robotont/robotont-electronics-power-management-board/README.md

# robotont-electronics-power-management-board
The repository contains schematics and PCB layout for the Robotont power management board.
The [production](Production/) folder contains prepared gerbers with pos file ready to order a from e.g. JLCPCB.

## Schematics
Schematic

## Layout

The following figures visualize the front side of the board along with the 3D model of the design.

PCB Layout
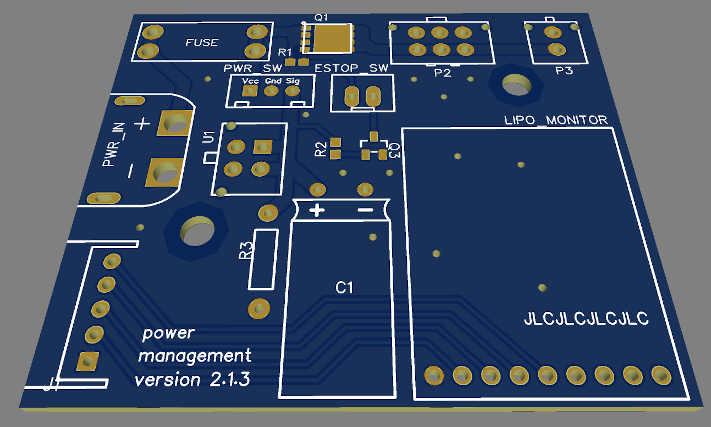
[picture p1: docs/robotont-power-management-board-3d.png]
3D View
