robotont/robotont-electronics-power-management-board/Production/robotont_power_management_board_schematic.pdf

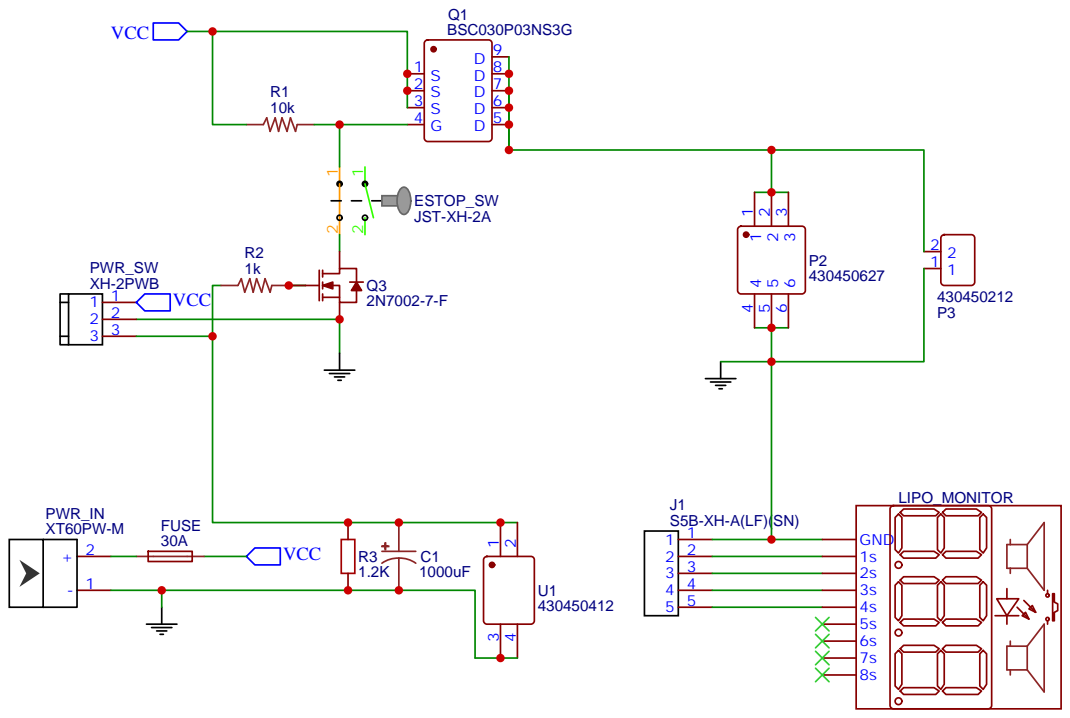
[picture p2: page 1]

Company: University of Tartu

Drawn By: Veiko Vunder
