robotont/robotont-electronics-power-management-board/(list of files, drawings)

Other design files:
EasyEDA_PCB_power_management.json
EasyEDA_SCH_power_management.json
