robotont/robotont-electronics-power-management-board/robotont-power-management-board.kicad_pcb

## KiCad design robotont-power-management-board.kicad_pcb (2021-10-05)

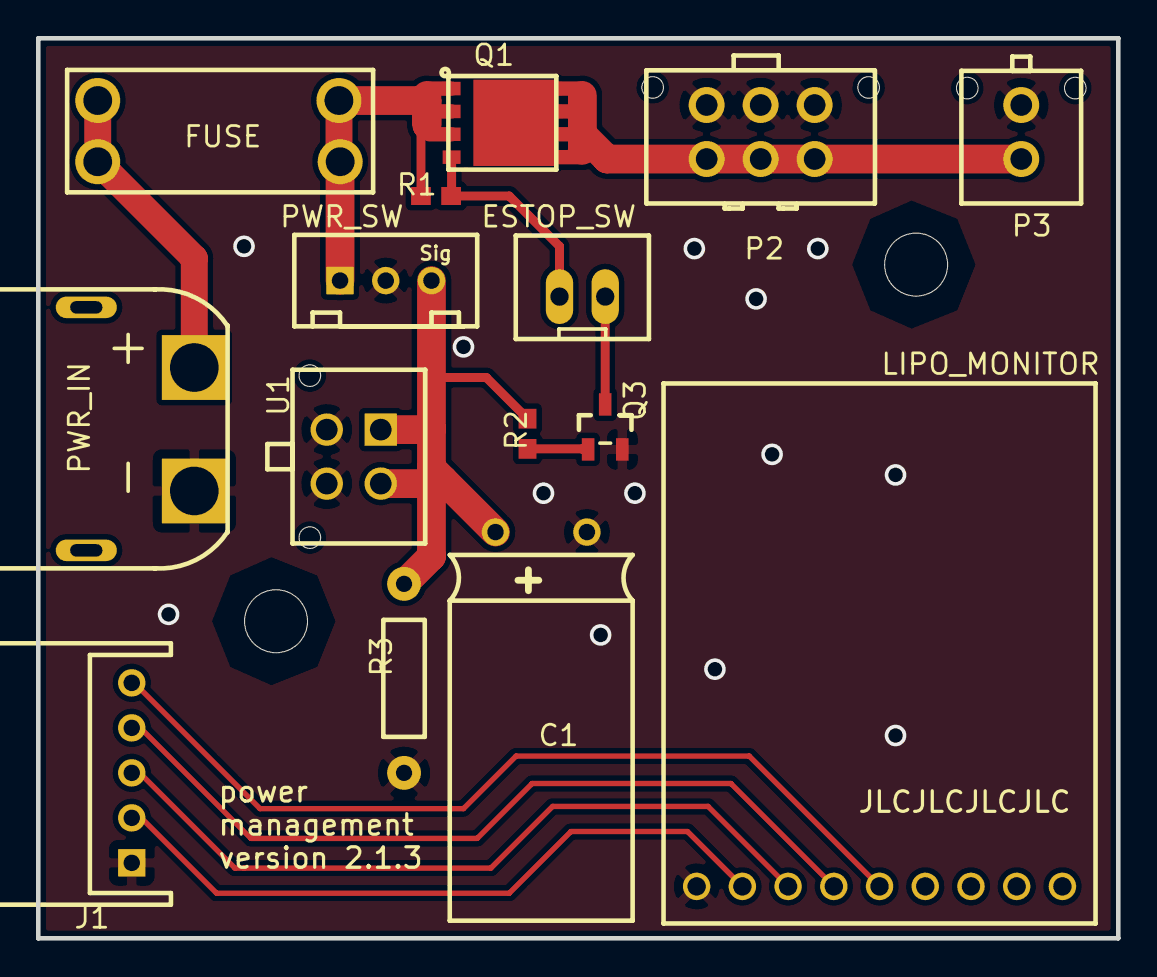
[picture p3: board robotont-power-management-board.kicad_pcb from above]

Board: 2 copper layers, 60.0 x 50.0 mm, 15 parts (0 on the bottom side), 12 nets.

Parts:
C1: +; ELECTROLYTIC CAP HORIZONTAL 10X20MM
ESTOP_SW: 1; JST-XH-02-PACKAGE-LONG-PAD
FUSE: 30A; 3557-2
J1: S5B-XH-A(LF)(SN); JST-XH-S5B-XH-A
LIPO_MONITOR: LiPo Tester; LIPO_BATTERY_TESTER
P2: 430450627
P3: 430450212
PWR_IN: XT60PW-M; XT60PW-M PCBLIB
PWR_SW: Sig; JST-XH-3PIN TD
Q1: BSC030P03NS3G; SON-8_5MMX6MM
Q3: 2N7002-7-F; SOT-23-3_L2.9-W1.6-P1.90-LS2.8-BR
R1: 10k; 0603-RES
R2: 1k; 0603-RES
R3: 1.2K; RES-TH_BD2.3-L6.5-P10.50-D0.5
U1: 430450412; CONN-TH_4P-P3.00-S3.00_L7.4-W9.7-EH9.0

Connections:
C1_2: C1.2, PWR_SW.3, R2.1, R3.2, U1.1, U1.2
ESTOP_SW_1: ESTOP_SW.1, Q1.4, R1.2
ESTOP_SW_2: ESTOP_SW.2, Q3.3
FUSE_1: FUSE.1, PWR_IN.2
GND: C1.1, J1.1, LIPO_MONITOR.1, P2.4, P2.5, P2.6, P3.1, PWR_IN.1, PWR_SW.2, Q3.2, R3.1, U1.3, U1.4
J1_2: J1.2, LIPO_MONITOR.2
J1_3: J1.3, LIPO_MONITOR.3
J1_4: J1.4, LIPO_MONITOR.4
J1_5: J1.5, LIPO_MONITOR.5
Q1_5: P2.1, P2.2, P2.3, P3.2, Q1.5, Q1.6, Q1.7, Q1.8, Q1.9
R2_2: Q3.1, R2.2
VCC: FUSE.2, PWR_SW.1, Q1.1, Q1.2, Q1.3, R1.1
