robotont/robotont-electronics-power-management-board/(commit log)

2021-10-05 pcb converted from easyeda
    [EasyEDA_PCB_power_management.json, EasyEDA_SCH_power_management.json, robotont-power-management-board.kicad_pcb, robotont-power-management-board.sch]
2022-02-03 pasted in an image of easyeda schematic
    [robotont-power-management-board.sch]
2023-03-10 bom txt -> csv
    [robotont_power_management_board_BOM.csv]
